dotmake-bj/Miao-House/README.md

# Miao-House
"Miao House" is a project initiated to provide winter shelter for stray dogs and cats.

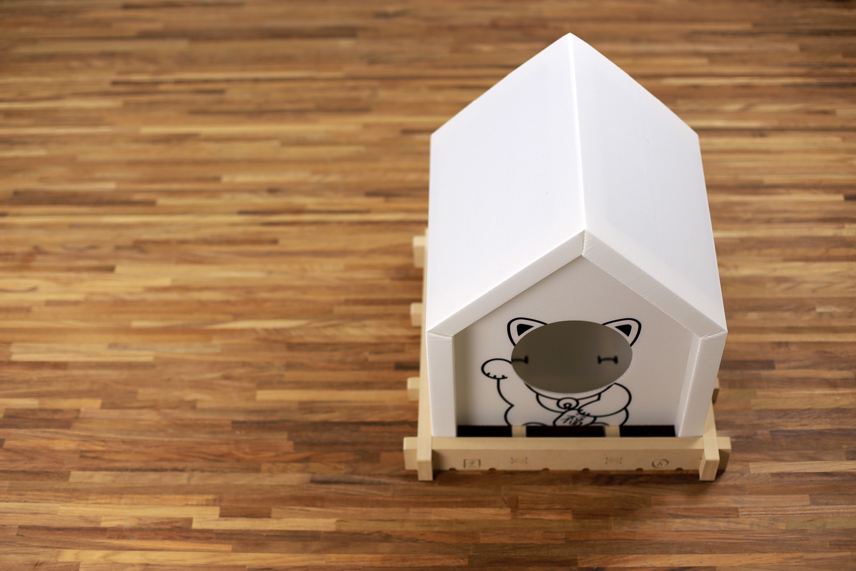
[picture p1: 喵房.jpg]


_切割图.dwg: 喵房主体结构的切割图纸，包括切割轮廓及尺寸，DWG格式文件；
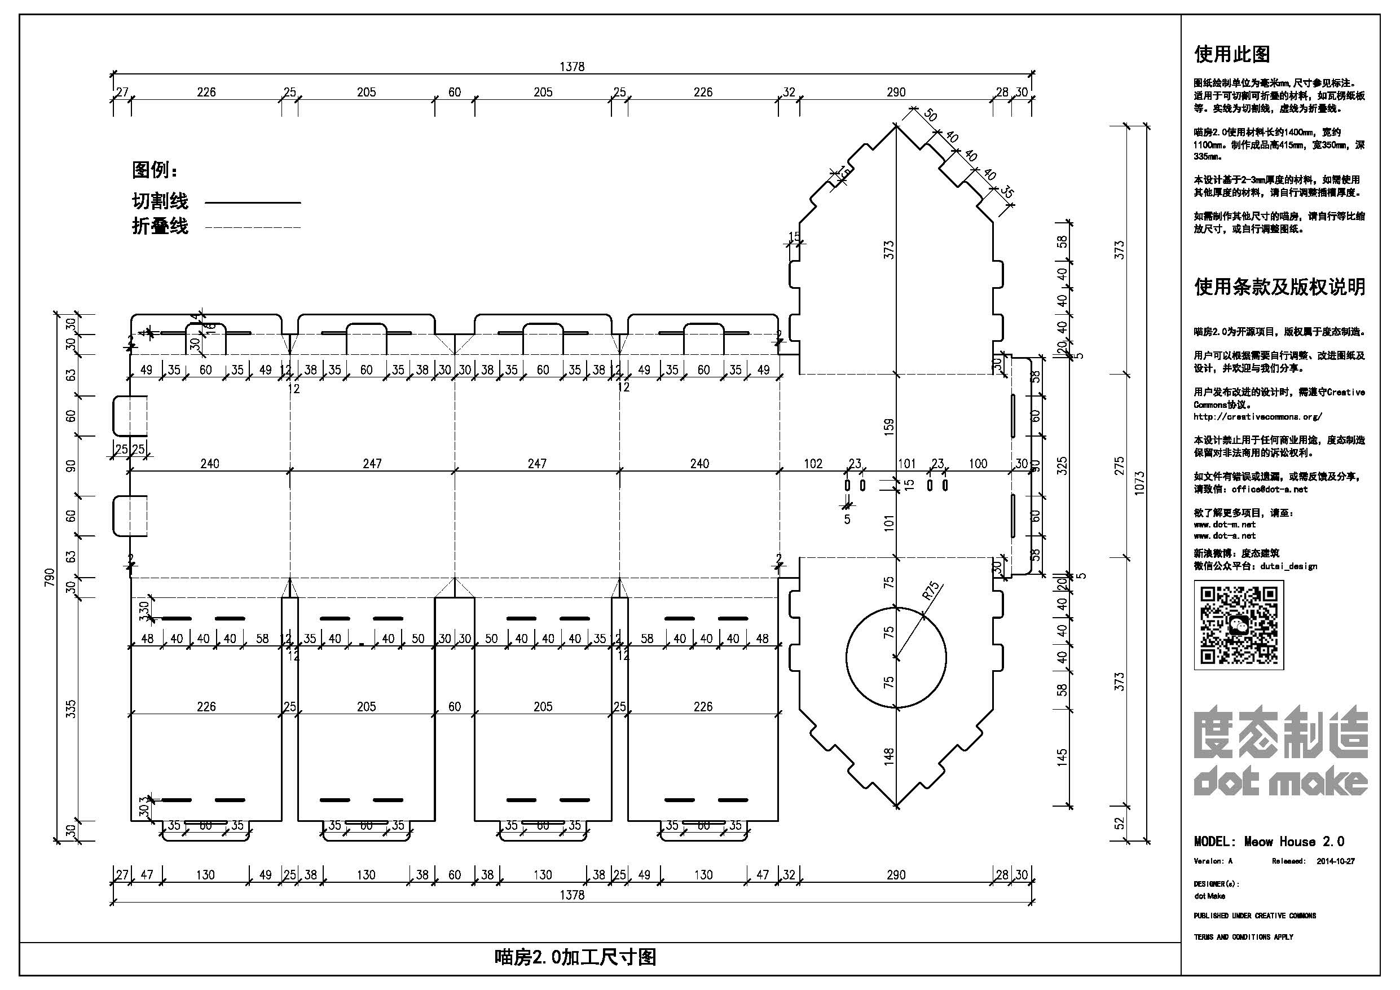
[picture p2: 切割图.jpg]


_切割图.pdf: 喵房主体结构的切割图纸，包括切割轮廓及尺寸，PDF格式文件；

_拼装指南.pdf: 喵房主体拼装步骤指南，黑白矢量图纸；
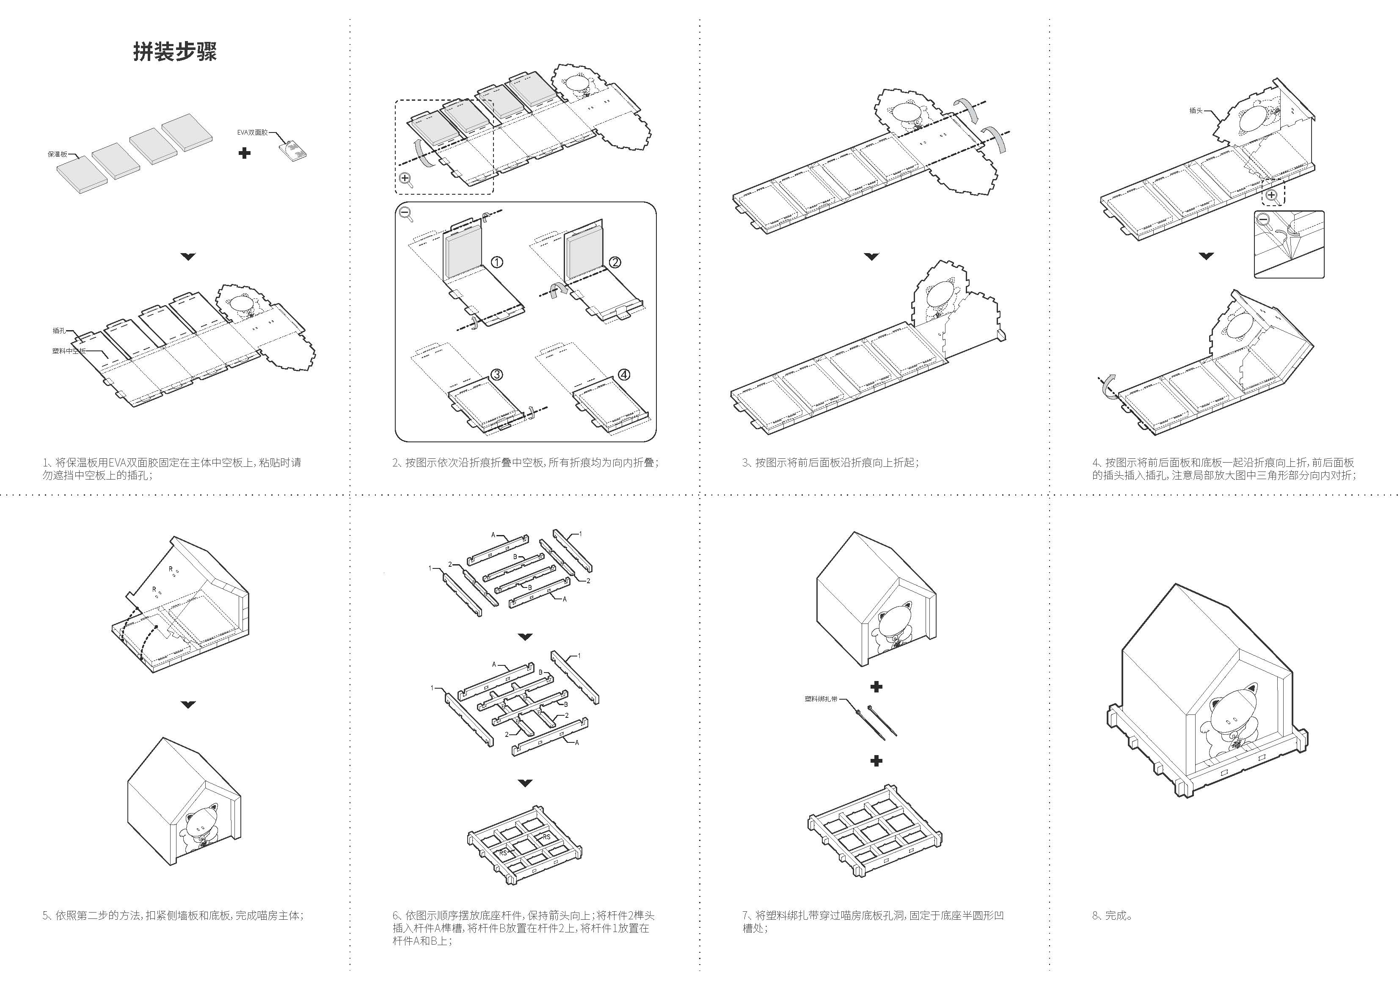
[picture p3: 拼装指南.jpg]


_图片版拼装指南.pdf：喵房主体拼装步骤指南，多页实物拍摄彩色图片；
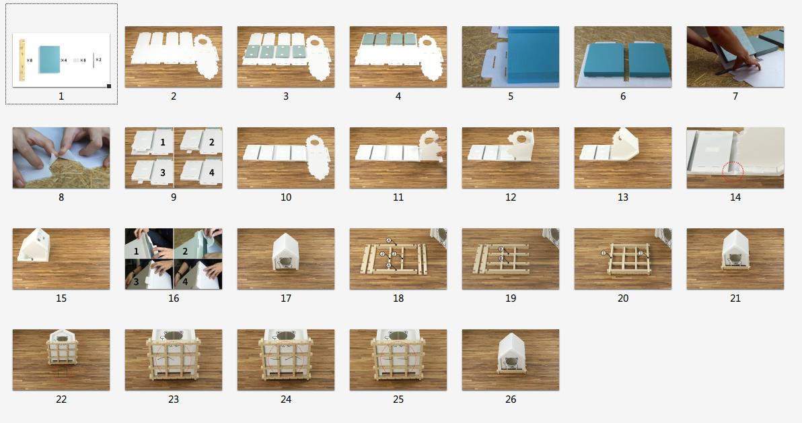
[picture p4: 图片版拼装指南.jpg]


_简易图片版拼装指南.pdf：喵房主体拼装步骤指南，单页多图实物拍摄彩色图片；
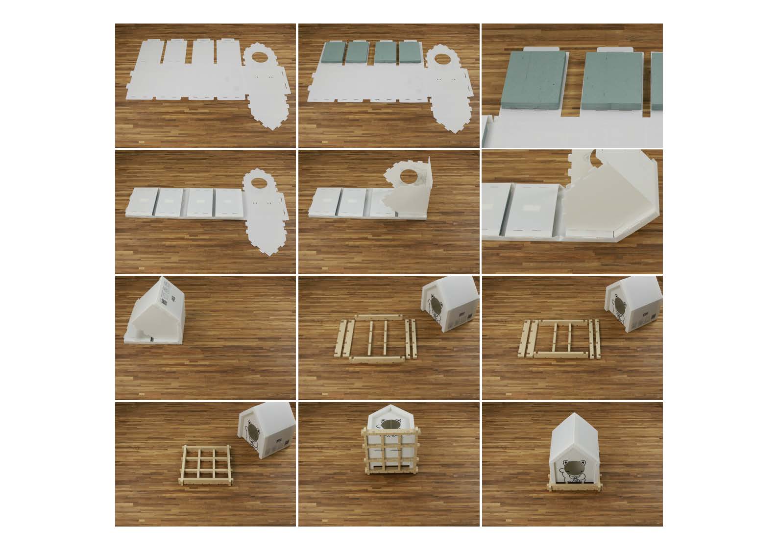
[picture p5: 简易图片版拼装指南.jpg]
