dotmake-bj/Miao-House/简易图片版拼装指南.pdf

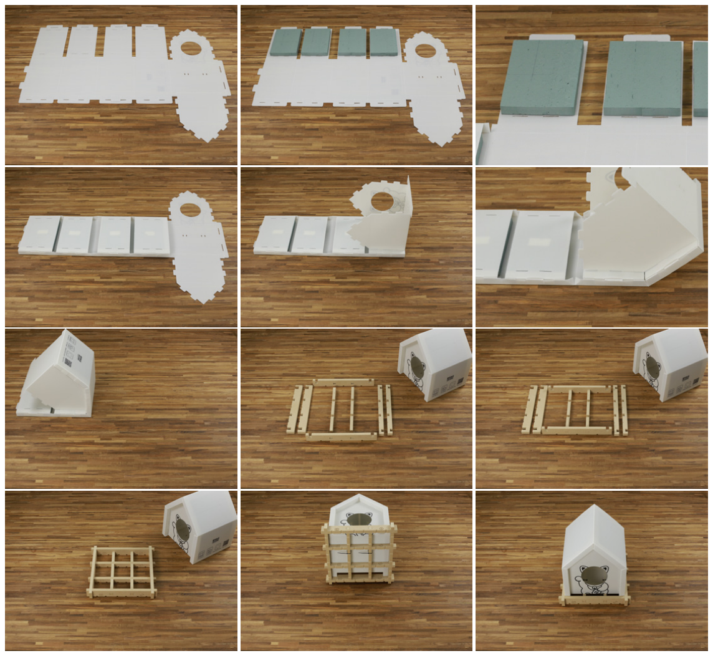
[picture p6: page 1]
