dotmake-bj/Miao-House/cover_cat.jpg

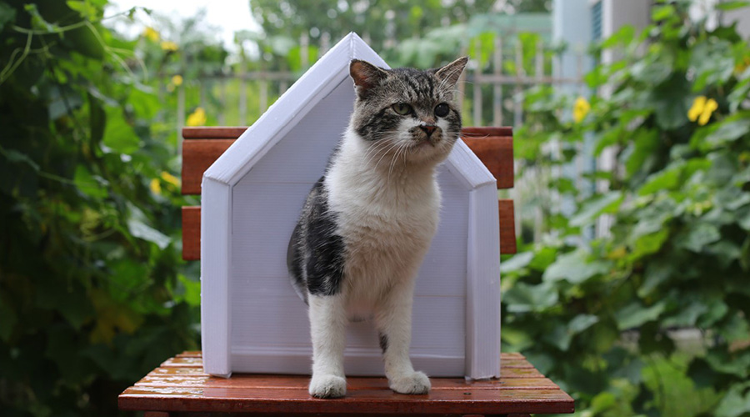
cover_cat.jpg
