dotmake-bj/Miao-House/(list of files, cad)

Other CAD files:
切割图.dwg
