dotmake-bj/Miao-House/切割图.pdf

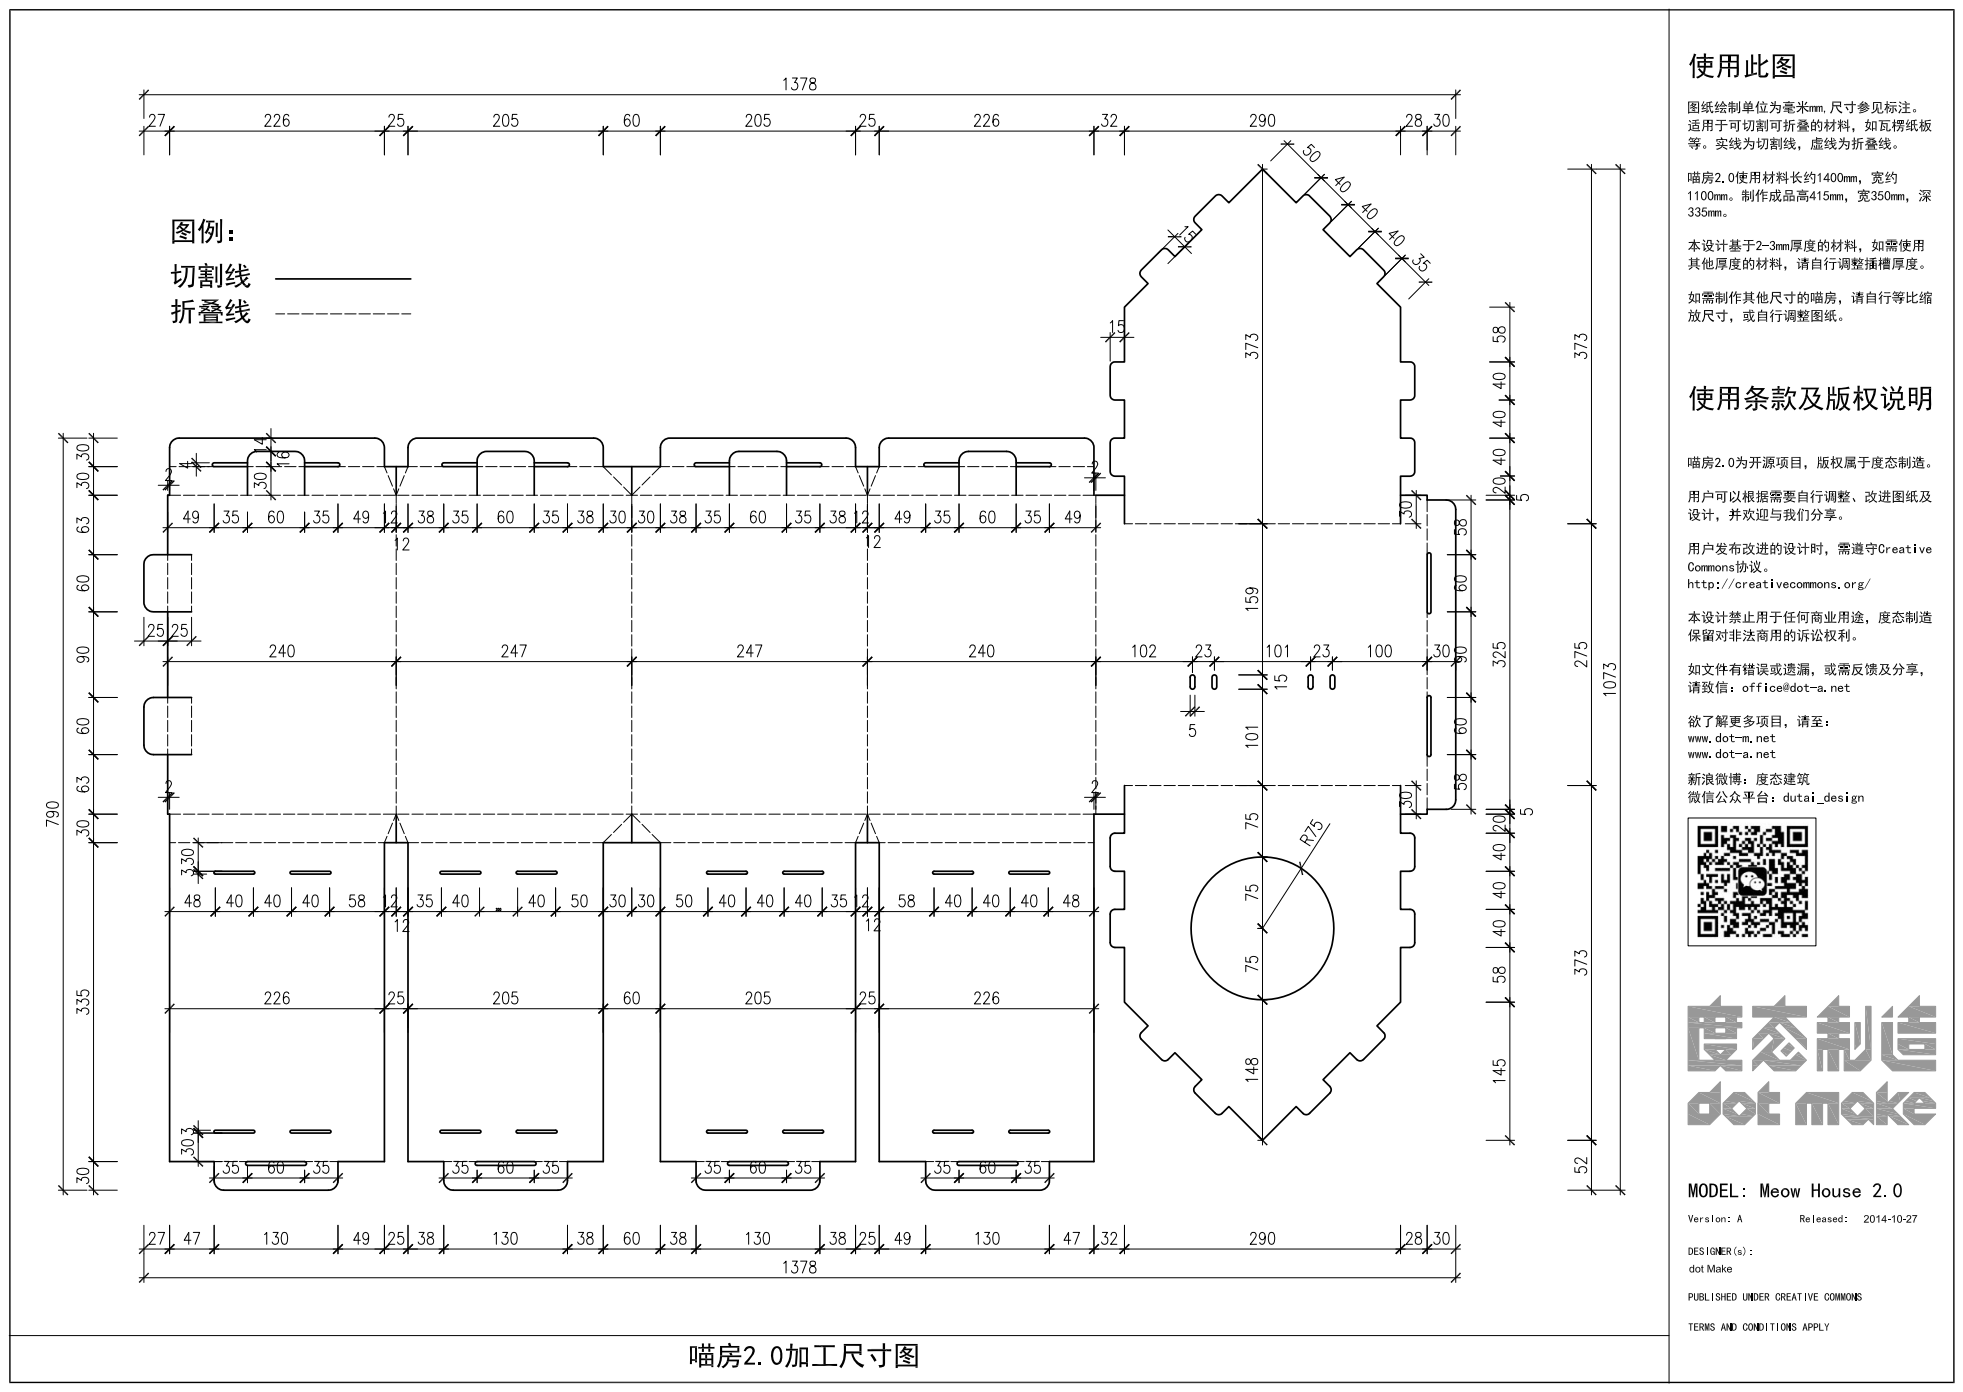
[picture p8: page 1]
