dotmake-bj/Miao-House/拼装指南.pdf

# 拼装步骤

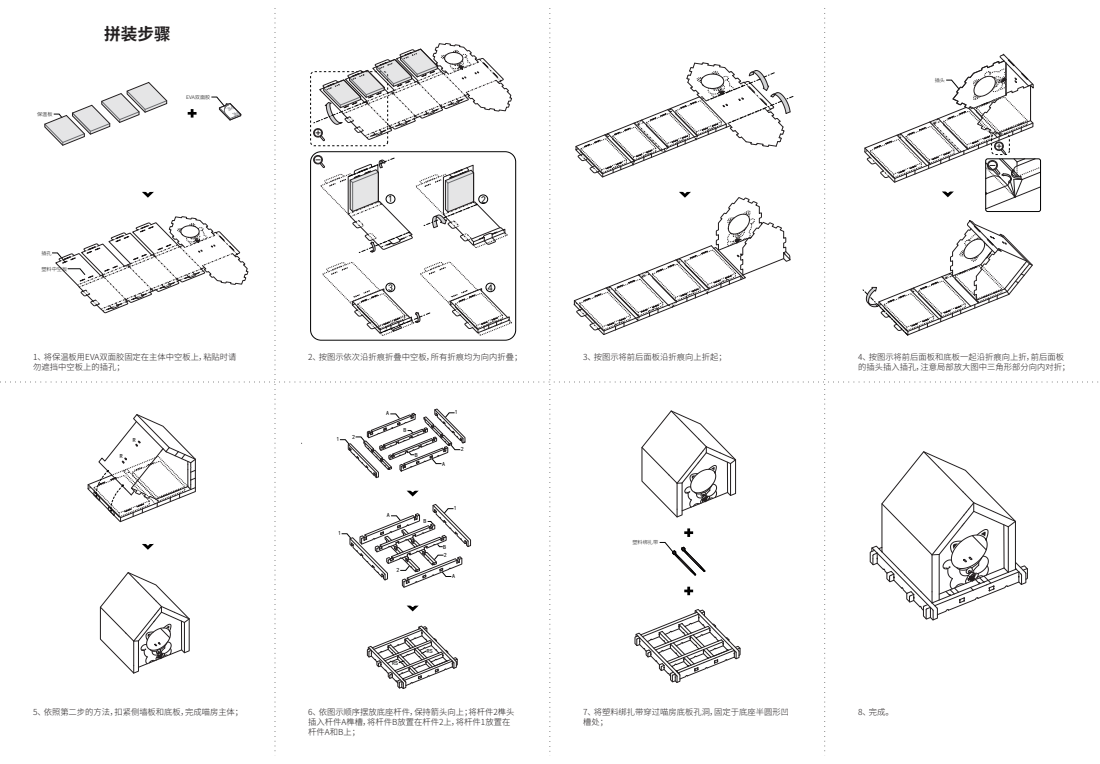
[picture p9: page 1]
插孔 塑料中空板; 保温板; EVA双面胶; 塑料绑扎带; 1、 将保温板用EVA双面胶固定在主体中空板上，粘贴时请 勿遮挡中空板上的插孔；; 2、 按图示依次沿折痕折叠中空板，所有折痕均为向内折叠；; 6、 依图示顺序摆放底座杆件，保持箭头向上；将杆件2榫头 插入杆件A榫槽，将杆件B放置在杆件2上，将杆件1放置在 杆件A和B上；; 3、 按图示将前后面板沿折痕向上折起；; 7、 将塑料绑扎带穿过喵房底板孔洞，固定于底座半圆形凹 槽处；; 4、 按图示将前后面板和底板一起沿折痕向上折，前后面板 的插头插入插孔，注意局部放大图中三角形部分向内对折；

5、 依照第二步的方法，扣紧侧墙板和底板，完成喵房主体；
